bluecodesthings/lodestone-project/focus-pod/BOM.md

# Bill of materials

Prices are rough CAD estimates (Montreal, late 2026). Check them before ordering. Most parts come in multi-packs, so the first pod costs the most.

## Per pod
| Qty | Part | Spec | Search term |
|---|---|---|---|
| 1 | Printed top | `print/pod-top.3mf`, ~9.6 g PLA | — |
| 1 | Printed base | `print/pod-base.3mf`, ~9.8 g PLA | — |
| 1 | Steel weight | 38.1 × 34 × 6.35 mm, cut from 1½″ × ¼″ flat bar (~65 g) | "steel flat bar 1-1/2 x 1/4" |
| 1 | NFC tag | **On-metal** NTAG215, Ø25 mm (ferrite-backed) | "anti-metal NTAG215 25mm" |
| 4 | Heat-set inserts | M2, length 3–4 mm, OD ≈ 3.5 mm (for a 3.2 mm hole) | "M2 heat set insert brass" |
| 4 | Screws | M2 × 6 mm countersunk/flat head (ISO 10642 / DIN 7991), stainless | "M2x6 countersunk screw" |
| 4 | Feet | Clear silicone bumper, Ø10 mm, 2.5–4 mm tall | "silicone bumper feet 10mm" |
| — | Glue for the feet | CA glue + polyolefin primer (plain super glue barely sticks to silicone) | "Loctite Plastics Bonding System" |

## Shopping list and cost
| Item | Pack | Est. price (CAD) | Pods per pack |
|---|---|---|---|
| Steel flat bar 1½″×¼″×36″ (Home Depot / Rona / Canadian Tire) | 1 bar | $20–30 | ~25 |
| …or an offcut from Metal Supermarkets (they can cut to length) | offcut | $5–10 | a few |
| On-metal NTAG215 Ø25 mm | 10 | $12–18 | 10 |
| Plain NTAG215 stickers (optional, for testing) | 30 | $10–12 | 30 |
| M2 heat-set inserts | 100 | $10–15 | 25 |
| M2 × 6 countersunk screws | 50–100 | $8–12 | 12–25 |
| Silicone bumper feet Ø10 mm | 100 | $8–10 | 25 |
| Loctite Plastics Bonding System | 1 | ~$10 | many |
| Printing (~20 g) | — | $1–15 (makerspace vs. service) | 1 |

**First pod:** about $60–90 including the packs. **Each extra pod:** about $5 plus printing.

## Tools
- Hacksaw (metal blade) + flat file, or have the steel cut at the store
- Soldering iron with a conical tip (for the inserts). Makerspaces usually have one.
- Small Phillips/hex driver to match the screws
- Kitchen scale (optional, to check the weight)
