bluecodesthings/lodestone-project/focus-pod/cad/pod-assembly-with-steel.step

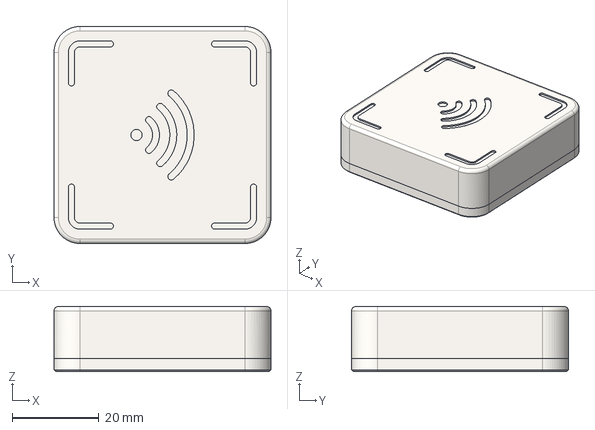
[picture p10: CAD file, 2026-11-05]
focus-pod/cad/pod-assembly-with-steel.step
50.0 x 50.0 x 15.0 mm
