bluecodesthings/lodestone-project/night-pod/cad/pod-assembly.step

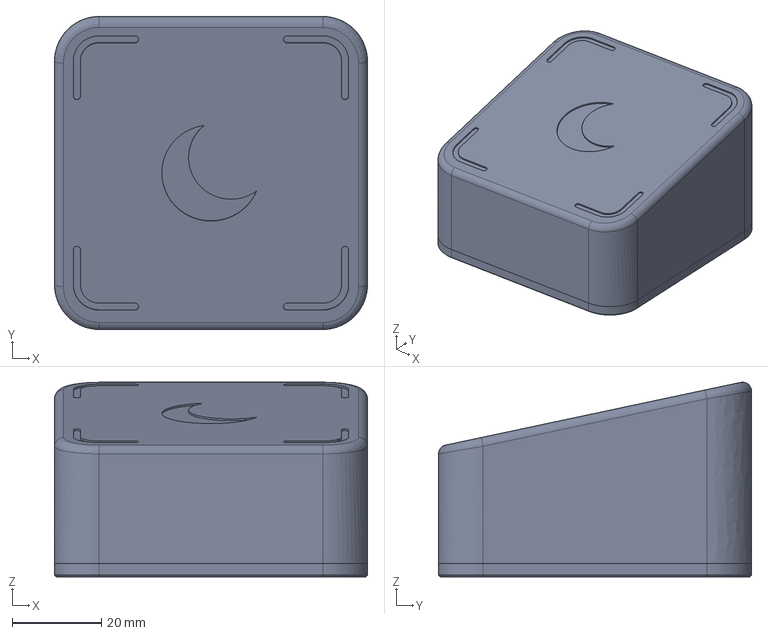
[picture p11: CAD file, 2026-11-06]
night-pod/cad/pod-assembly.step
70.0 x 70.0 x 43.5 mm
