bluecodesthings/lodestone-project/focus-pod/cad/pod-top.step

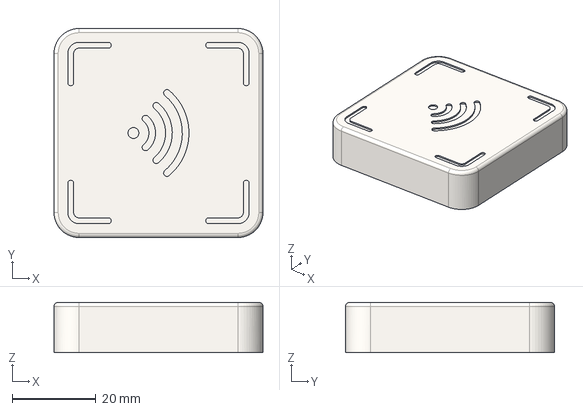
[picture p12: CAD file, 2026-11-05]
focus-pod/cad/pod-top.step
50.0 x 50.0 x 12.0 mm
