bluecodesthings/lodestone-project/night-pod/cad/pod-base.step

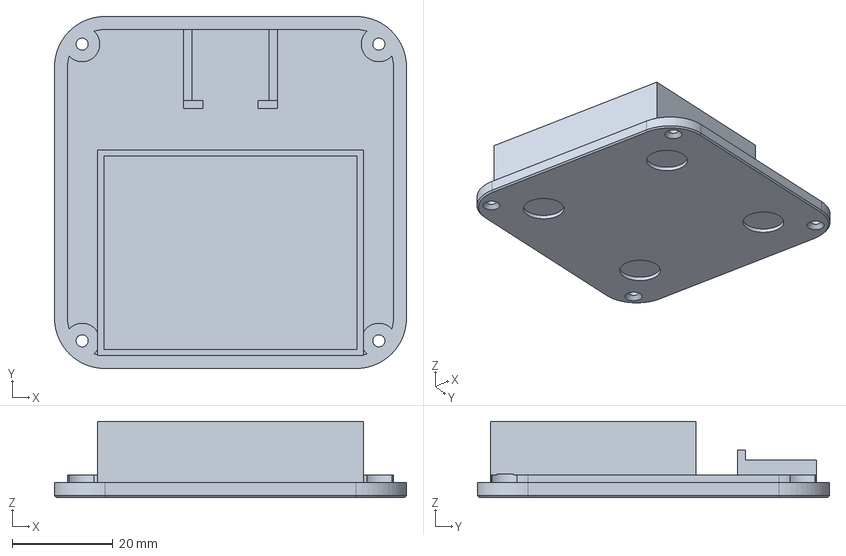
[picture p13: CAD file, 2026-11-06]
night-pod/cad/pod-base.step
70.0 x 70.0 x 15.2 mm
