bluecodesthings/lodestone-project/night-pod/print/mcgill-submission/pod-top.stl

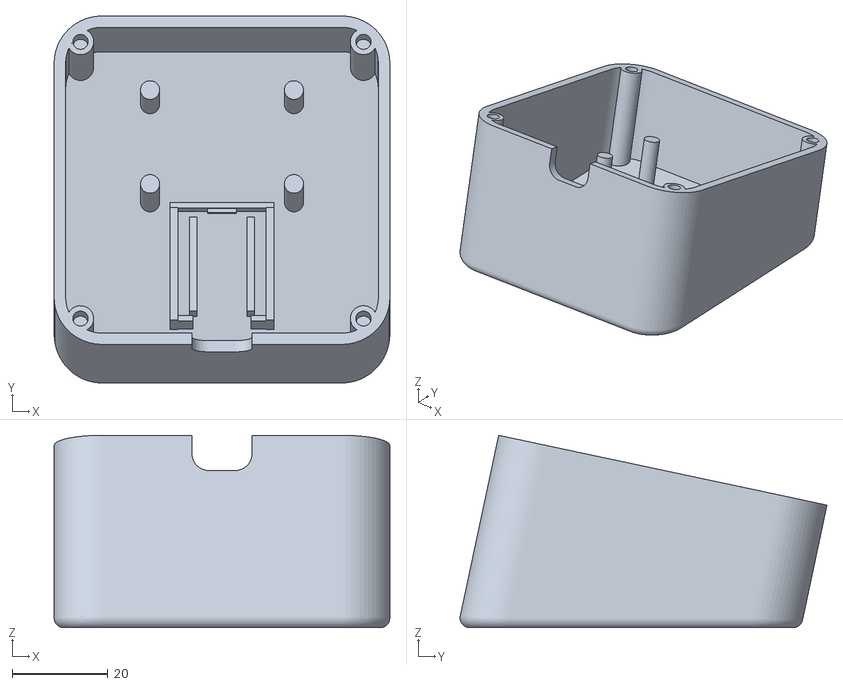
[picture p14: CAD file, 2026-11-06]
night-pod/print/mcgill-submission/pod-top.stl
70.0 x 76.5 x 40.1
