bluecodesthings/lodestone-project/focus-pod/cad/pod-base.step

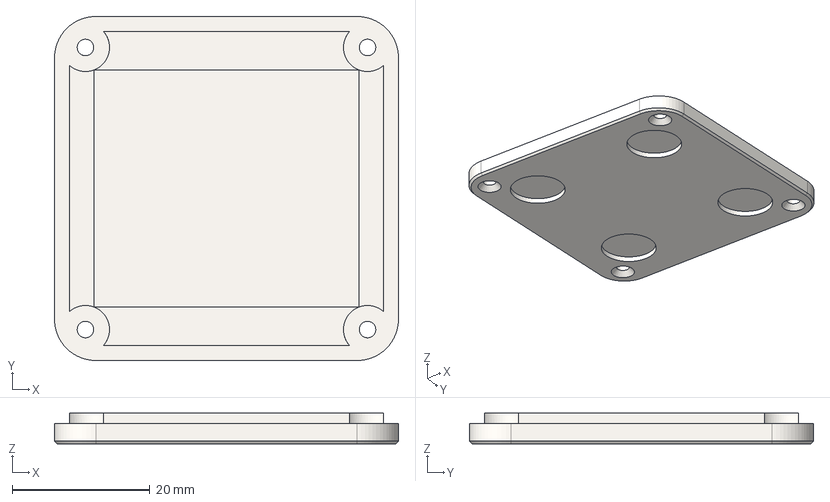
[picture p15: CAD file, 2026-11-05]
focus-pod/cad/pod-base.step
50.0 x 50.0 x 4.50 mm
