bluecodesthings/lodestone-project/night-pod/cad/pod-top.step

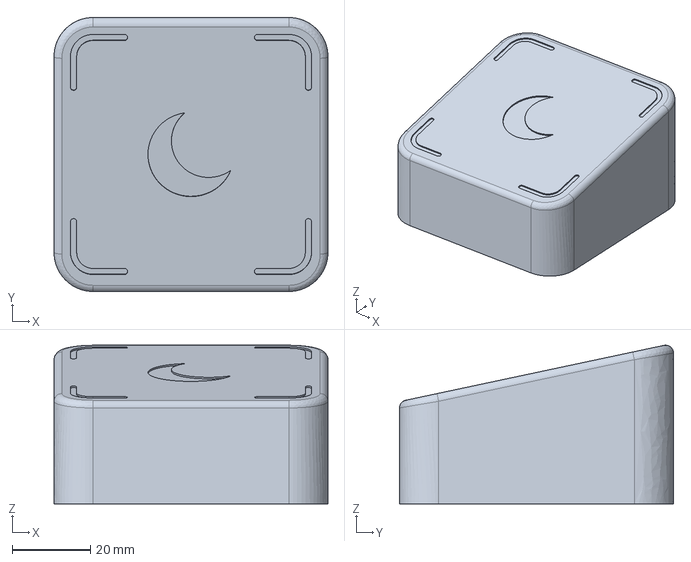
[picture p16: CAD file, 2026-11-06]
night-pod/cad/pod-top.step
70.0 x 70.0 x 40.5 mm
