bluecodesthings/lodestone-project/(list of files, cad)

Other CAD files:
night-pod/print/mcgill-submission/pod-base.stl
focus-pod/print/mcgill-submission/pod-top.stl
focus-pod/print/mcgill-submission/pod-base.stl
focus-pod/print/pod-base.3mf
focus-pod/print/pod-base.stl
focus-pod/print/pod-top.3mf
focus-pod/print/pod-top.stl
night-pod/print/pod-base.3mf
night-pod/print/pod-base.stl
night-pod/print/pod-top.3mf
night-pod/print/pod-top.stl
