bluecodesthings/lodestone-project/night-pod/print/mcgill-submission/SUBMISSION-NOTES.md

# McGill Schulich Library 3D printing request: Night Pod

Upload `pod-top.stl` and `pod-base.stl` from this folder. Material: **PLA** (dark blue if available).

## Comments box
```
2 parts that fit together (enclosure top + base), ~5.5 h total, ~65 g PLA.

- pod-top.stl is already rotated so its sloped top face is flat on the bed. Please don't rotate it.
- pod-base.stl: flat side down as supplied.
- Please print at 100% scale with no horizontal expansion, because the parts fit together with 0.2 mm clearance.
- Settings if possible: 0.2 mm layers, 4 walls, 6 top/bottom layers, 100% infill.
- No supports needed.

Thank you!
```
