bluecodesthings/lodestone-project/(commit log)

2026-11-05 Lodestone Focus Pod: enclosure CAD, print files and build docs
    [pod-assembly-with-steel.step, pod-base.3mf, pod-base.step, pod-base.stl, pod-top.3mf, pod-top.step, pod-top.stl]
2026-11-06 Lodestone Night Pod: enclosure CAD, print files, beacon firmware and docs
    [pod-assembly.step, pod-base.3mf, pod-base.step, pod-base.stl, pod-top.3mf, pod-top.step, pod-top.stl]
2026-11-06 Night Pod: 12-degree angled top, USB-C moved to the bottom via extension
    [pod-assembly.step, pod-base.3mf, pod-base.step, pod-base.stl, pod-top.3mf, pod-top.step, pod-top.stl]
